ToshioWoo/Submersible-Mechanical-Crab/MCG2101 - Group 13 Deliverable 1.docx

MCG2101 – Intro Design of MCG Systems

Deliverable 1

Group 13

Names:

Haneen Barghouti

Lara Al Nakeeb

Emma Cochran

Linh Nguyen

Toshio Woo

Definition of Mandate

The mandate is to develop a design for the manufacture of a European Green Crab mechanical mimic to aid in underwater exploration and research in the Gulf of St. Lawrence. The design must be suitable for operation in benthic and coastal environments on various irregular and deformable surfaces, typical of the crab’s preferred environment. The design must operate in the Gulf of St. Lawrence, near shore, in shallow waters less than 6 meters in depth, and in temperatures between -5ºC and 20ºC. It should be able to travel through the Gulf’s various environments including salt marshes, sandy beaches, and sheltered areas such as eelgrass beds. The device must be able to mimic the lateral locomotion and orientation of a European Green Crab with maximum stability. The mimic must be able to attach to the seabed, must be able to reposition itself should it become stuck, and must be able to flip itself over if it falls upside down. The device must interact with and monitor marine life while minimizing disturbances to the surrounding ecosystem. It must be capable of collecting data with a sampling mechanism; however, its observation and locomotion procedures must minimize water turbidity, disruption to sediment, damage to vegetation, and interference with other marine organisms. The device must be made of material that is resistant to sun, salt, and sand damage. Furthermore, the material properties must not harm or disrupt other marine life. The design’s structure should maximize the mimic’s resemblance to the green crab and should be between 70mm and 86mm in carapace breadth, and it must also be compatible with conventional manufacturing processes available in Canada.

Criteria and Restrictions

Operational Characteristics:

1. [C] Stability of system for observation must be maximized
2. [C] Stability must not be compromised due to uneven surfaces (ex. rocks, sand).
3. [C] Robot’s ability to orient itself for observation must be maximized.
4. [C] Total mass should be minimized.
5. [C] Operability while fully submerged under water must be maximized.
6. [C] Causes no disruption to surrounding organisms or environment in operation.
7. [R] Material must not be hazardous to the crab species or other organisms.
8. [C] Effect of heat from exposure to sunlight on the system must be minimized.
9. [R] Crab must be less than 86mm
10. [C] Ease of sample collection is maximized.
11. …
12. [R] Must have no sharp edges or exposed mechanical/electrical elements.
13. [C] Reliability of all subsystems during prolonged use in coastal environment must be maximized.
14. [C] Ease of the robot’s retrieval and deployment must be maximized.
15. [C] Need for maintenance/servicing should be minimized.
16. [R] Must tolerate water depths of at least 6 meters.
17. [C] Movement precision when system is controlled must be maximized.
18. [R] Operation not affected in temperature ranges of the Gulf of St. Lawrence from -5°C to 20°C.
19. [C] Maximized operational ability on irregular terrain found in coastal environments such as pebbled, muddy or sandy surfaces.
20. …
21. [C] Ability to navigate strong currents or contact with debris must be maximized
22. [R] Carapace must be less than 86mm in diameter

Tree Structure Criteria & Restriction

1. Stability
2. Surface
3. Orientation
4. Mass
5. Submersion
6. Disruption
7. Biocompatibility
8. Thermal exposure
9. Compactness
10. Sample collection
11. …
12. Safety
13. Reliability
14. Deployment
15. Maintainability
16. Tolerate Water Depths
17. Movability
18. Temperature Adaptability
19. Operational Ability
20. …
21. Navigation

System Data & Structure

0.10 0.10

Spy Crab Design

1.0

Mechanical & Structural Design

0.25 0.25

0.35 Stability 0.0875

0.3 Surface 0.075

0.25 Orientation 0.0625

0.1 Mass 0.025

1 Thermal Exposure 0.15

Compactness

1 Disruption 0.15

Biocompatibility

Safety

…

…

0.3 Sample Collection0.03

0.25 Maintainability 0.025

0.45 Reliability 0.045

Tolerate Water Depths

1 Submersion 0.15

Temperature Adaptability

0.15 Deployment 0.03

Operational

0.35 Ability 0.07

0.2 Movability 0.04

0.3 Navigation 0.06

Tree Structure

System Requirements

0.15 0.15

Environmental Impact

0.15 0.15

Environmental Tolerance

0.15 0.15

Operational Performance

0.20 0.20

Technical Specification

Criteria & Restrictions | Abs. Weighting | Benchmark
1. Stability maximized | 0.0875 | 0 falls/hour
2. Acceptable terrain types | 0.075 | All
3. Reorientation for view angle | 0.0625 | 360 degrees
4. Mass minimized | 0.025 | <3 kg
5. Submersion, waterproof materials | 0.15 | All
6. Disruption of environment | - | None
7. No biohazardous materials | - | None
8. Sun exposure time without damage | 0.06 | >50 hours
9. Compactness, main body size | 0.09 | 60-90 mm
10. Sample collection size | 0.03 | 5 to 15 mm
11. Seafloor disturbance | 0.15 | None
12. Safety (sharp edges, exposed electronics) | - | None
13. Reliability/lifetime | 0.045 | 500 working hours
14. Deployment and retrieval time | 0.03 | <5 min
15. Regular maintenance time | 0.025 | <20 min/10 working hours
16. Tolerate water depths | - | 6m minimum
17. Movement speed | 0.04 | 0 to 0.2 m/s
18. Working temperature range | - | -5 to 20 °C
19. Tolerable environmental conditions | 0.07 | 90% of days
20. Non-polluting | - | None
21. Tolerable external force (current, debris) | 0.06 | 5 km/h

MCG2101 Group 13
