ToshioWoo/Submersible-Mechanical-Crab/FULL ASSEMBLY 637pm28-03-26/FULL ASSEMBLY/Buoyancy Assembly V5/Buoyancy Assembly V5/Buoyancy Assembly.SLDASM

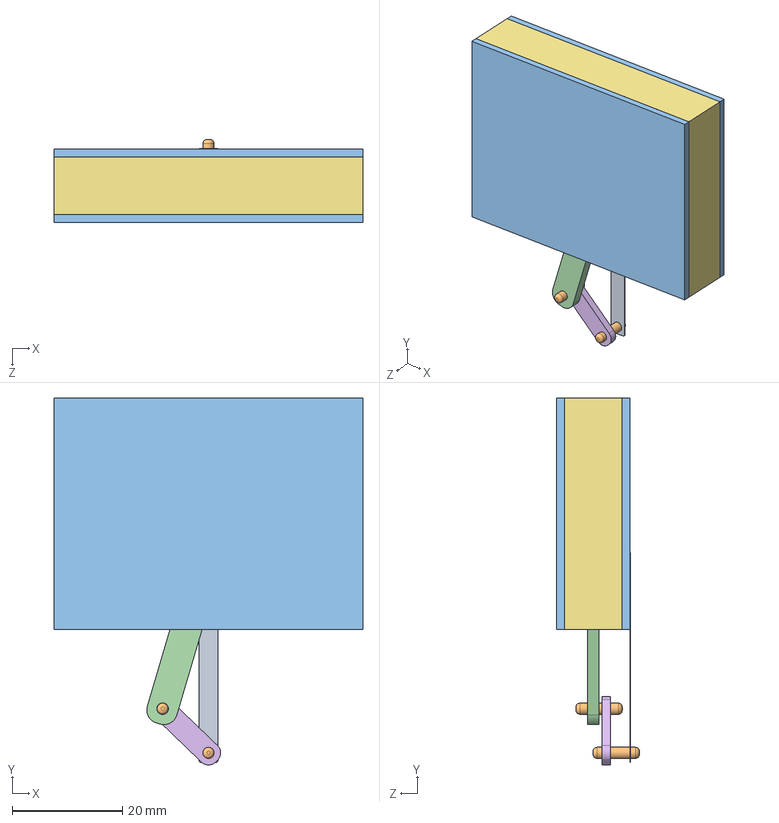
[picture p59: CAD file, 2026-11-10]
FULL ASSEMBLY 637pm28-03-26/FULL ASSEMBLY/Buoyancy Assembly V5/Buoyancy Assembly V5/Buoyancy Assembly.SLDASM
56.0 x 66.6 x 15.0 mm
Casing
Gear Arm 1
Pin
Piston Arm 2
Top and Bottom Casing x 2
Pin 3 x 2
Base Plate
