ToshioWoo/Submersible-Mechanical-Crab/FULL ASSEMBLY 637pm28-03-26/FULL ASSEMBLY/Crab v2/MCG2101_P6_SamplingAssembly_v2.SLDASM

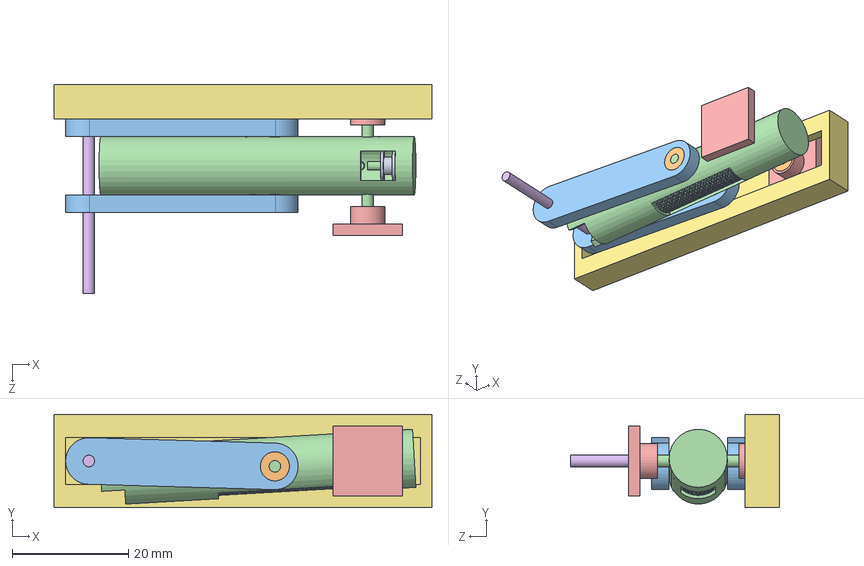
[picture p60: CAD file, 2026-11-10]
FULL ASSEMBLY 637pm28-03-26/FULL ASSEMBLY/Crab v2/MCG2101_P6_SamplingAssembly_v2.SLDASM
65.0 x 16.0 x 36.0 mm
MCG2101_P6_LeftCase
MCG2101_P6_ShaftM
MCG2101_P6_Slider x 2
MCG2101_P5_Cylinder
MCG2101_P6_Linkage x 2
MCG2101_P6_2-5_Bearing x 4
MCG2101_P6_H_Pulley
