ToshioWoo/Submersible-Mechanical-Crab/FULL ASSEMBLY 637pm28-03-26/FULL ASSEMBLY/FULL ASSEMBLY V1 -LARA/Buoyancy/Buoyancy Assembly.SLDASM

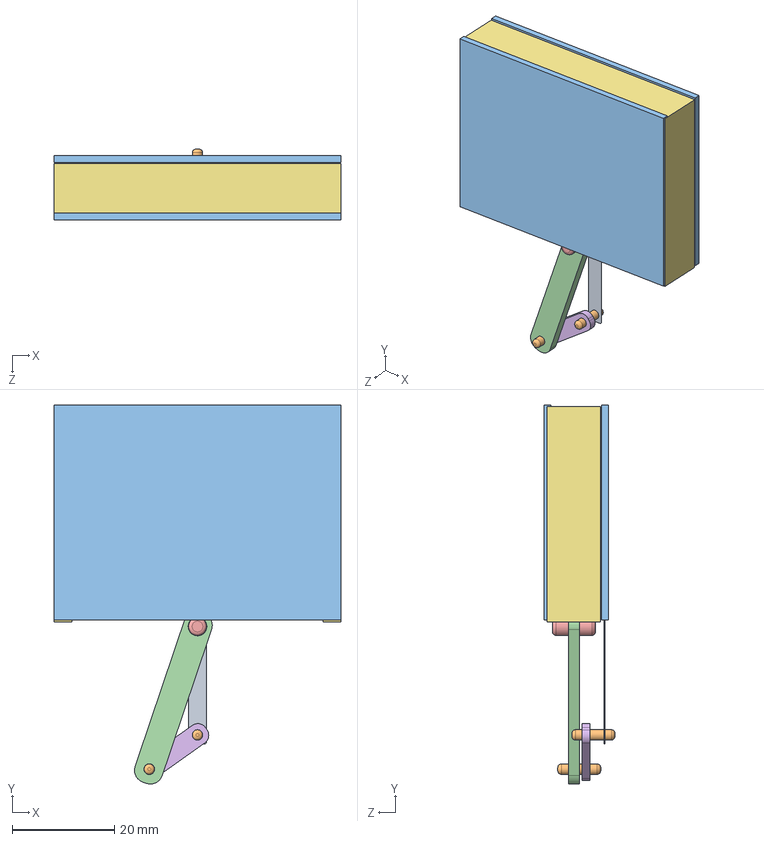
[picture p61: CAD file, 2026-11-10]
FULL ASSEMBLY 637pm28-03-26/FULL ASSEMBLY/FULL ASSEMBLY V1 -LARA/Buoyancy/Buoyancy Assembly.SLDASM
56.0 x 74.0 x 13.8 mm
Casing
Gear Arm 1
Pin
Piston Arm 2
Top and Bottom Casing x 2
Pin 3 x 2
Base Plate
