ToshioWoo/Submersible-Mechanical-Crab/FULL ASSEMBLY 637pm28-03-26/FULL ASSEMBLY/Buoyancy Assembly V5/Buoyancy Assembly V5/Casing.SLDPRT

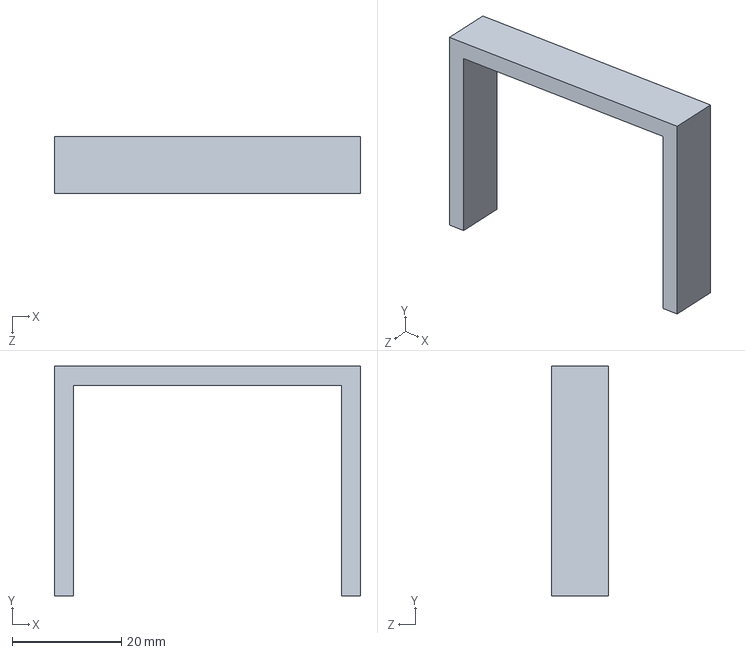
[picture p62: CAD file, 2026-11-10]
FULL ASSEMBLY 637pm28-03-26/FULL ASSEMBLY/Buoyancy Assembly V5/Buoyancy Assembly V5/Casing.SLDPRT
56.0 x 42.0 x 10.5 mm
