ToshioWoo/Submersible-Mechanical-Crab/FULL ASSEMBLY 637pm28-03-26/FULL ASSEMBLY/Crab v2/MCG2101_P6_S_Pulley.SLDPRT

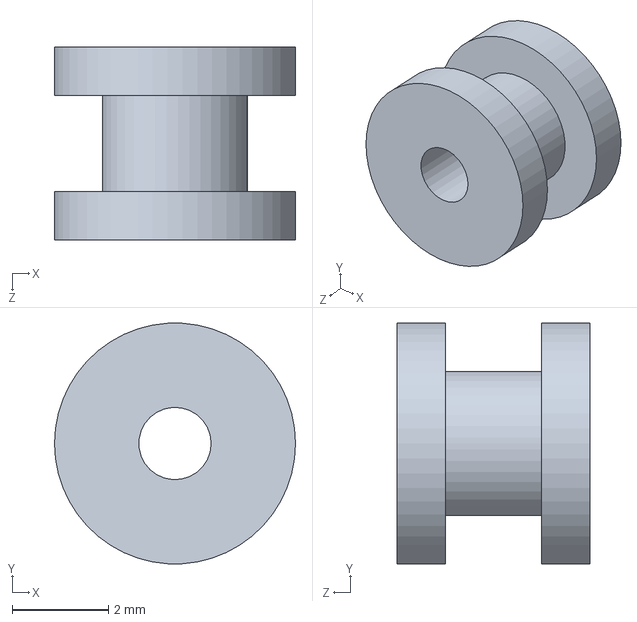
[picture p63: CAD file, 2026-11-10]
FULL ASSEMBLY 637pm28-03-26/FULL ASSEMBLY/Crab v2/MCG2101_P6_S_Pulley.SLDPRT
5.00 x 4.99 x 4.00 mm
