ToshioWoo/Submersible-Mechanical-Crab/FULL ASSEMBLY 637pm28-03-26/FULL ASSEMBLY/Crab v2/Toolbox parts/Metric - Straight bevel gear 0.25M 12GT 12PT 20PA 12FW ---12O75H2MD2N.SLDPRT

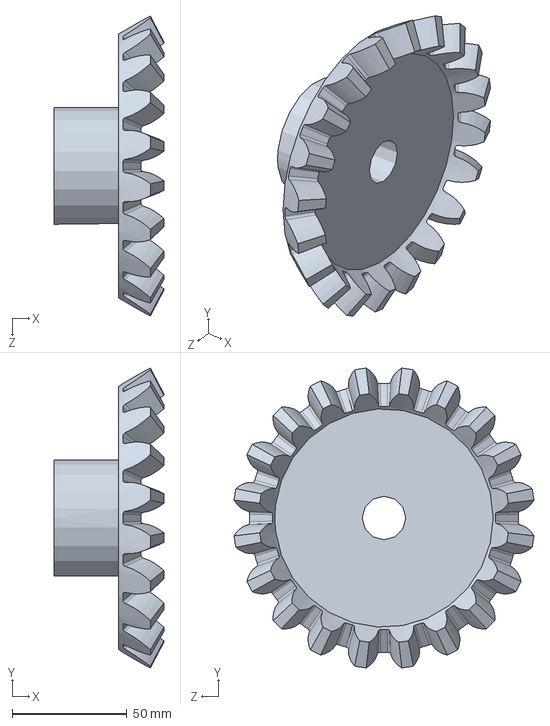
[picture p64: CAD file, 2026-11-10]
FULL ASSEMBLY 637pm28-03-26/FULL ASSEMBLY/Crab v2/Toolbox parts/Metric - Straight bevel gear 0.25M 12GT 12PT 20PA 12FW ---12O75H2MD2N.SLDPRT
47.8 x 130.7 x 130.7 mm
