ToshioWoo/Submersible-Mechanical-Crab/FULL ASSEMBLY 637pm28-03-26/FULL ASSEMBLY/FULL ASSEMBLY V1 -LARA/Buoyancy/New Claw Design - Part 1.SLDPRT

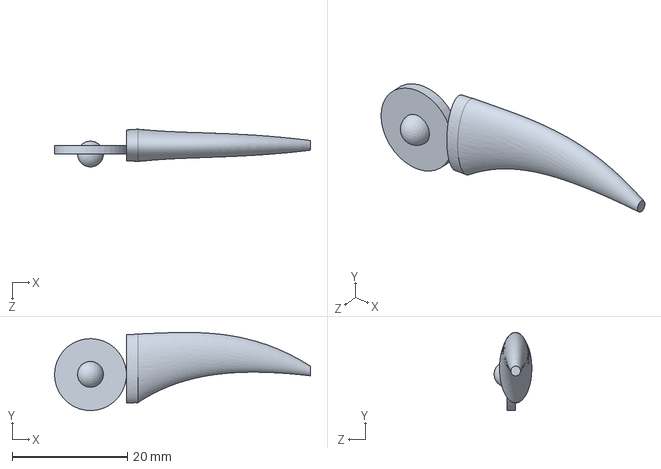
[picture p65: CAD file, 2026-11-10]
FULL ASSEMBLY 637pm28-03-26/FULL ASSEMBLY/FULL ASSEMBLY V1 -LARA/Buoyancy/New Claw Design - Part 1.SLDPRT
44.5 x 13.6 x 6.56 mm
