ToshioWoo/Submersible-Mechanical-Crab/FULL ASSEMBLY 637pm28-03-26/FULL ASSEMBLY/FULL ASSEMBLY V1 -LARA/Shell+Legs/Leg2_In.SLDPRT

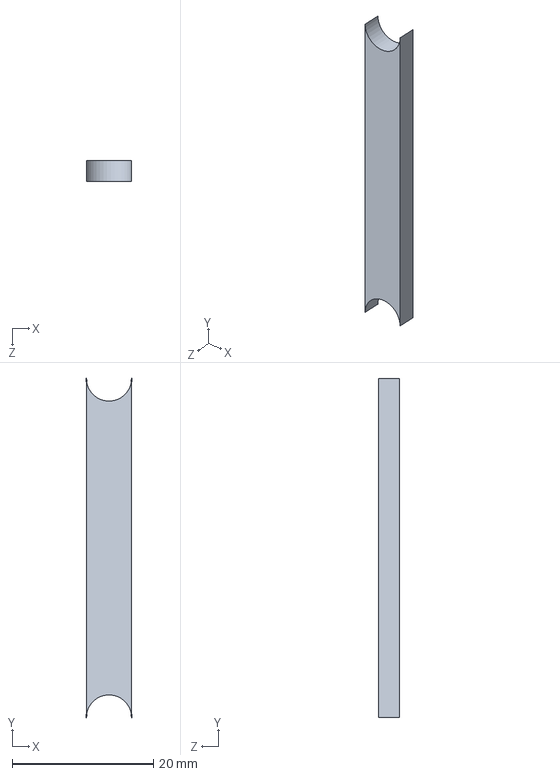
[picture p66: CAD file, 2026-11-10]
FULL ASSEMBLY 637pm28-03-26/FULL ASSEMBLY/FULL ASSEMBLY V1 -LARA/Shell+Legs/Leg2_In.SLDPRT
6.40 x 48.0 x 3.00 mm
