ToshioWoo/Submersible-Mechanical-Crab/FULL ASSEMBLY 637pm28-03-26/FULL ASSEMBLY/MCG 2101/MCG2101_P6_LeftCase._V2SLDPRT.SLDPRT

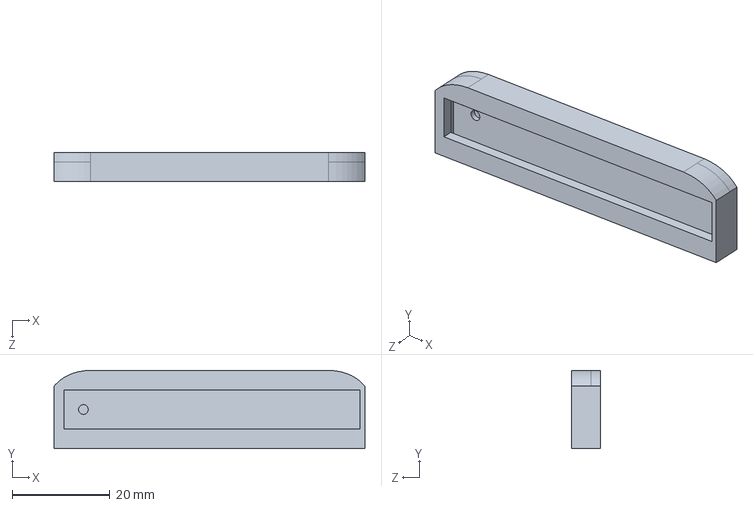
[picture p67: CAD file, 2026-11-10]
FULL ASSEMBLY 637pm28-03-26/FULL ASSEMBLY/MCG 2101/MCG2101_P6_LeftCase._V2SLDPRT.SLDPRT
63.5 x 16.0 x 6.00 mm
