ToshioWoo/Submersible-Mechanical-Crab/FULL ASSEMBLY 637pm28-03-26/FULL ASSEMBLY/MCG 2101/Toolbox parts/AFBMA 12.1.4.1 - 0015-4 - 8,SI,NC,8_68.SLDPRT

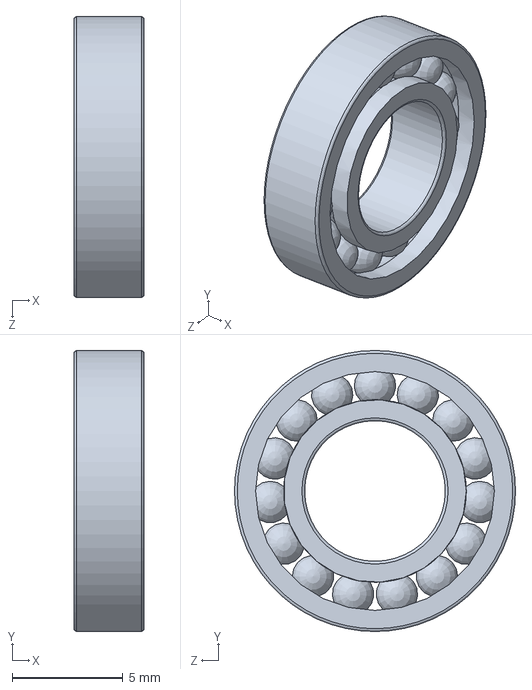
[picture p68: CAD file, 2026-11-10]
FULL ASSEMBLY 637pm28-03-26/FULL ASSEMBLY/MCG 2101/Toolbox parts/AFBMA 12.1.4.1 - 0015-4 - 8,SI,NC,8_68.SLDPRT
3.17 x 12.7 x 12.7 mm
