ToshioWoo/Submersible-Mechanical-Crab/FULL ASSEMBLY 637pm28-03-26/FULL ASSEMBLY/Buoyancy Assembly V5/Buoyancy Assembly V5/Base Plate.SLDPRT

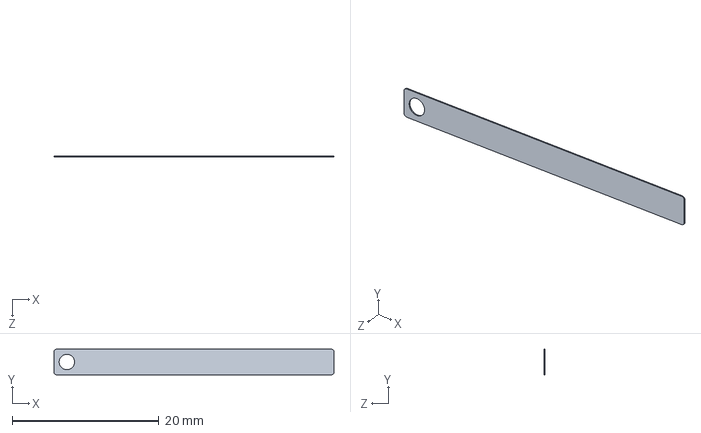
[picture p69: CAD file, 2026-11-10]
FULL ASSEMBLY 637pm28-03-26/FULL ASSEMBLY/Buoyancy Assembly V5/Buoyancy Assembly V5/Base Plate.SLDPRT
38.1 x 3.50 x 0.14 mm
