ToshioWoo/Submersible-Mechanical-Crab/FULL ASSEMBLY 637pm28-03-26/FULL ASSEMBLY/MCG 2101/MCG2101_P6_Linkage.SLDPRT

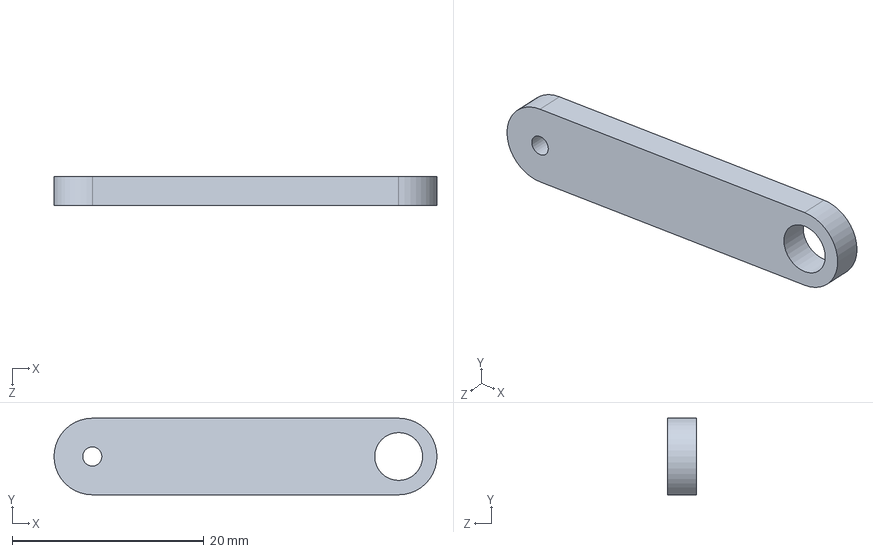
[picture p70: CAD file, 2026-11-10]
FULL ASSEMBLY 637pm28-03-26/FULL ASSEMBLY/MCG 2101/MCG2101_P6_Linkage.SLDPRT
40.0 x 8.00 x 3.00 mm
