ToshioWoo/Submersible-Mechanical-Crab/FULL ASSEMBLY 637pm28-03-26/FULL ASSEMBLY/Crab v2/MCG2101_P6_LeftCase.SLDPRT

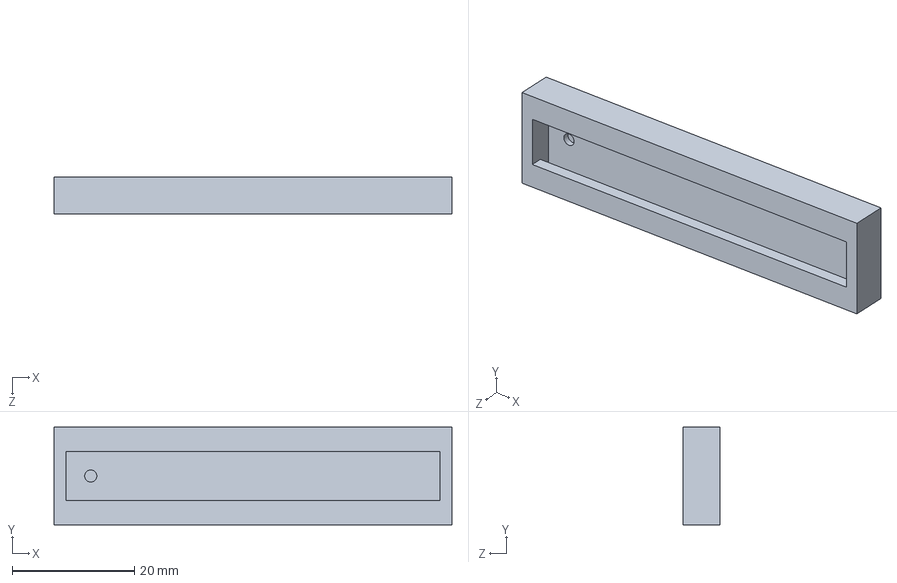
[picture p71: CAD file, 2026-11-10]
FULL ASSEMBLY 637pm28-03-26/FULL ASSEMBLY/Crab v2/MCG2101_P6_LeftCase.SLDPRT
65.0 x 16.0 x 6.00 mm
