ToshioWoo/Submersible-Mechanical-Crab/FULL ASSEMBLY 637pm28-03-26/FULL ASSEMBLY/FULL ASSEMBLY V1 -LARA/Buoyancy/Pin.SLDPRT

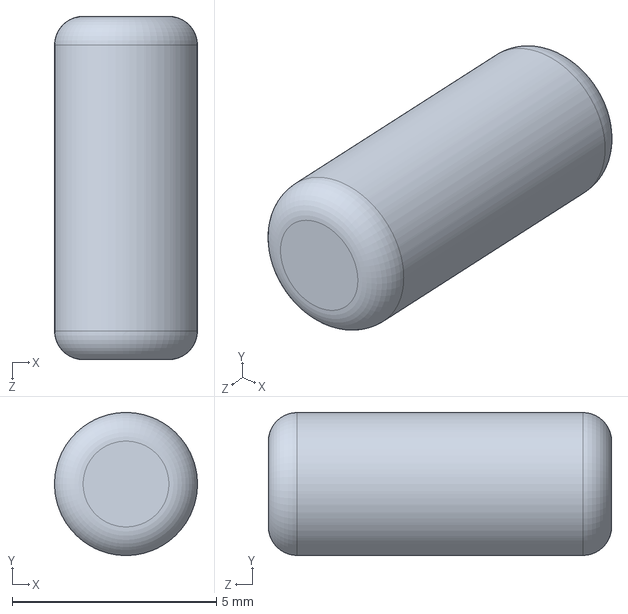
[picture p72: CAD file, 2026-11-10]
FULL ASSEMBLY 637pm28-03-26/FULL ASSEMBLY/FULL ASSEMBLY V1 -LARA/Buoyancy/Pin.SLDPRT
3.50 x 3.50 x 8.40 mm
