ToshioWoo/Submersible-Mechanical-Crab/FULL ASSEMBLY 637pm28-03-26/FULL ASSEMBLY/FULL ASSEMBLY V1 -LARA/Shell+Legs/Leg3_In.SLDPRT

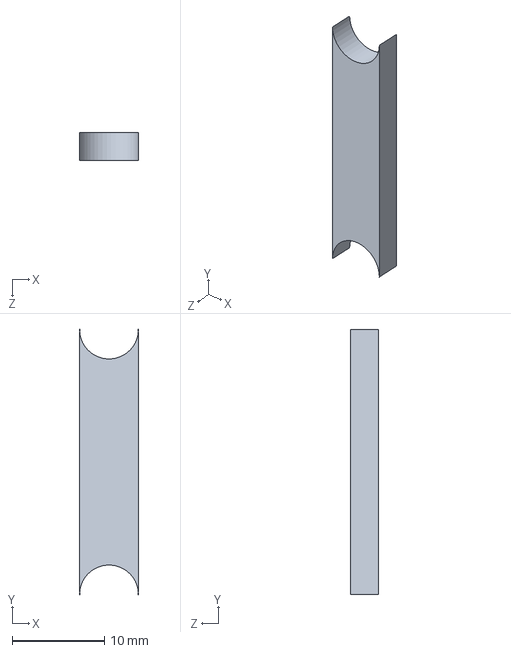
[picture p73: CAD file, 2026-11-10]
FULL ASSEMBLY 637pm28-03-26/FULL ASSEMBLY/FULL ASSEMBLY V1 -LARA/Shell+Legs/Leg3_In.SLDPRT
6.40 x 28.8 x 3.00 mm
