ToshioWoo/Submersible-Mechanical-Crab/FULL ASSEMBLY 637pm28-03-26/FULL ASSEMBLY/MCG 2101/MCG2101_P6_Slider.SLDPRT

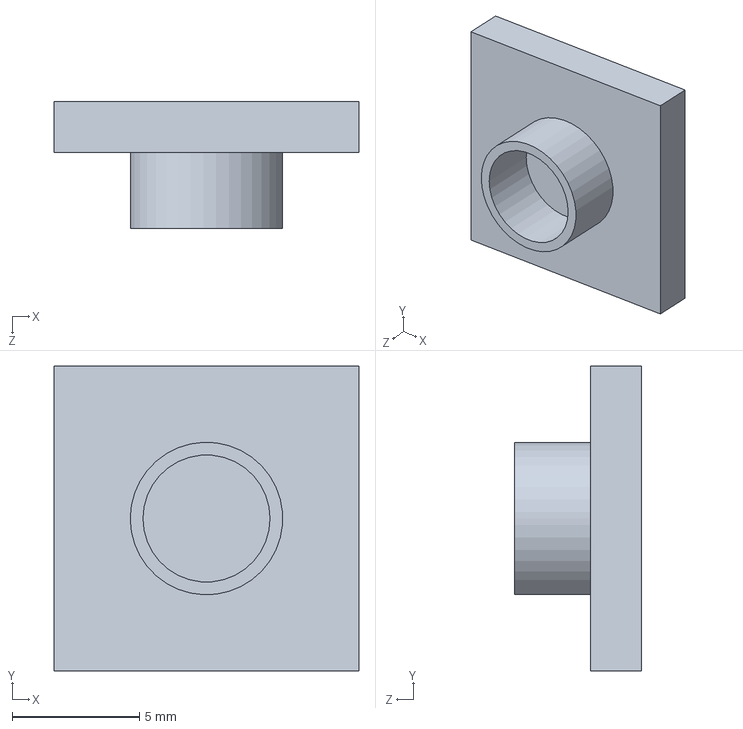
[picture p74: CAD file, 2026-11-10]
FULL ASSEMBLY 637pm28-03-26/FULL ASSEMBLY/MCG 2101/MCG2101_P6_Slider.SLDPRT
12.0 x 12.0 x 5.00 mm
