ToshioWoo/Submersible-Mechanical-Crab/FULL ASSEMBLY 637pm28-03-26/FULL ASSEMBLY/Buoyancy Assembly V5/Buoyancy Assembly V5/Top and Bottom Casing.SLDPRT

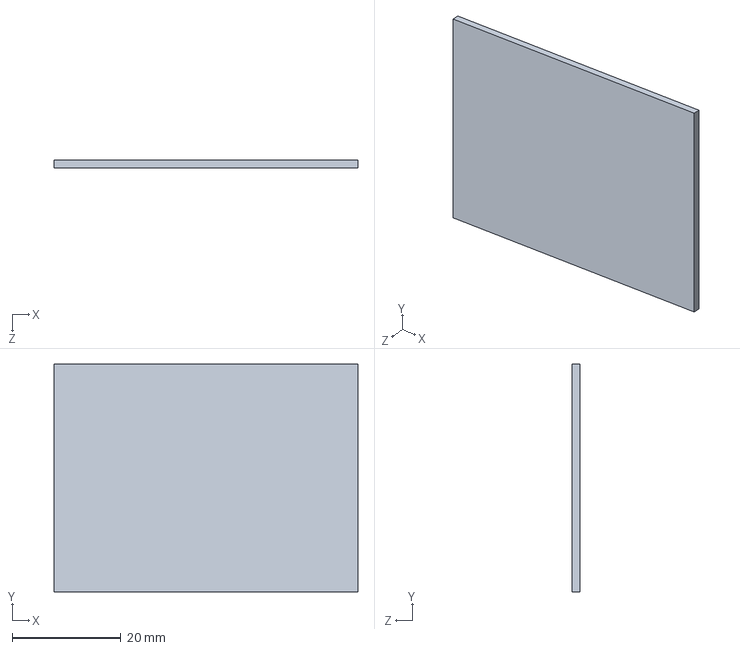
[picture p75: CAD file, 2026-11-10]
FULL ASSEMBLY 637pm28-03-26/FULL ASSEMBLY/Buoyancy Assembly V5/Buoyancy Assembly V5/Top and Bottom Casing.SLDPRT
56.0 x 42.0 x 1.40 mm
