ToshioWoo/Submersible-Mechanical-Crab/FULL ASSEMBLY 637pm28-03-26/FULL ASSEMBLY/Crab v2/MCG2101_P6_2-5_Bearing.SLDPRT

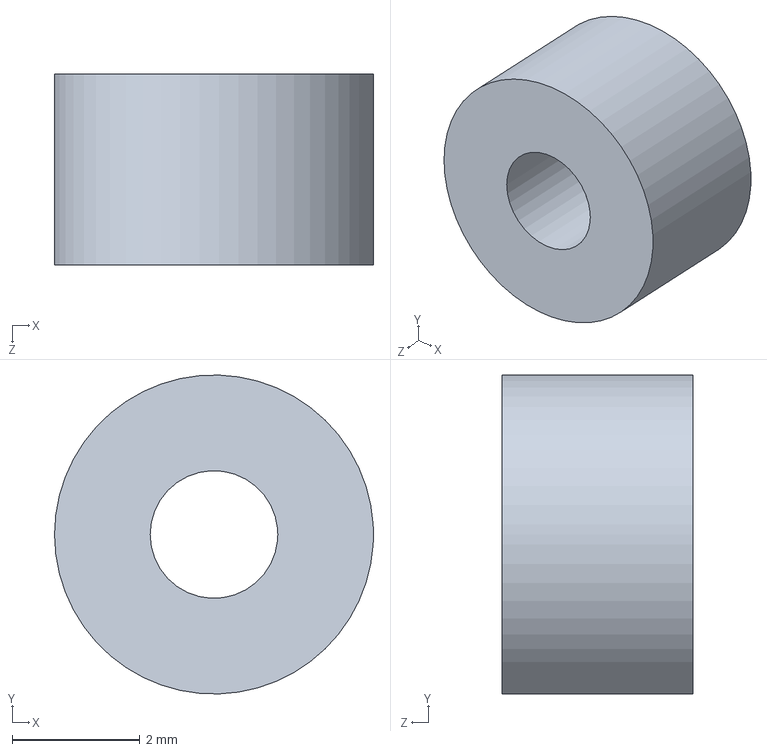
[picture p76: CAD file, 2026-11-10]
FULL ASSEMBLY 637pm28-03-26/FULL ASSEMBLY/Crab v2/MCG2101_P6_2-5_Bearing.SLDPRT
5.00 x 5.00 x 3.00 mm
