ToshioWoo/Submersible-Mechanical-Crab/FULL ASSEMBLY 637pm28-03-26/FULL ASSEMBLY/FULL ASSEMBLY V1 -LARA/Buoyancy/Gear Arm 1.SLDPRT

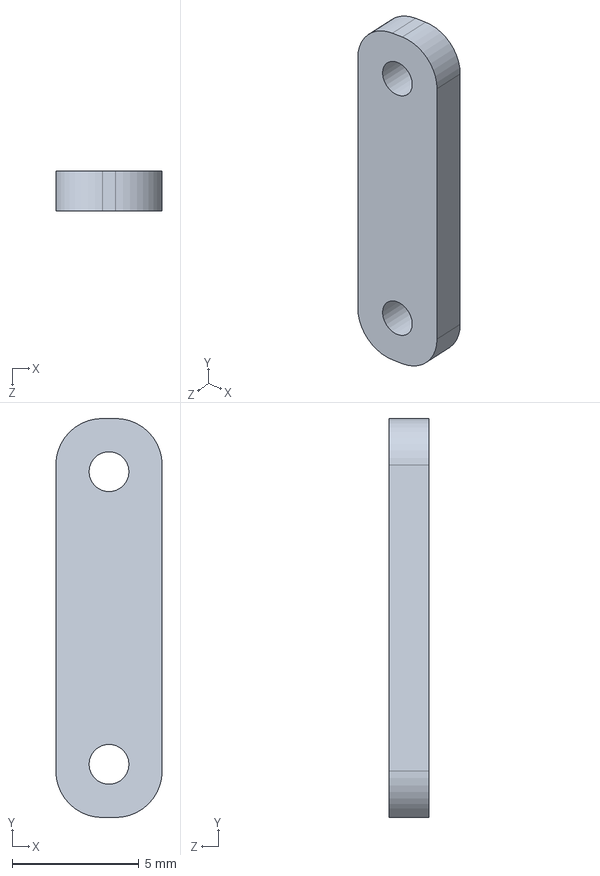
[picture p77: CAD file, 2026-11-10]
FULL ASSEMBLY 637pm28-03-26/FULL ASSEMBLY/FULL ASSEMBLY V1 -LARA/Buoyancy/Gear Arm 1.SLDPRT
4.20 x 15.8 x 1.58 mm
