ToshioWoo/Submersible-Mechanical-Crab/FULL ASSEMBLY 637pm28-03-26/FULL ASSEMBLY/MCG 2101/MCG2101_P5_Cylinder.SLDPRT

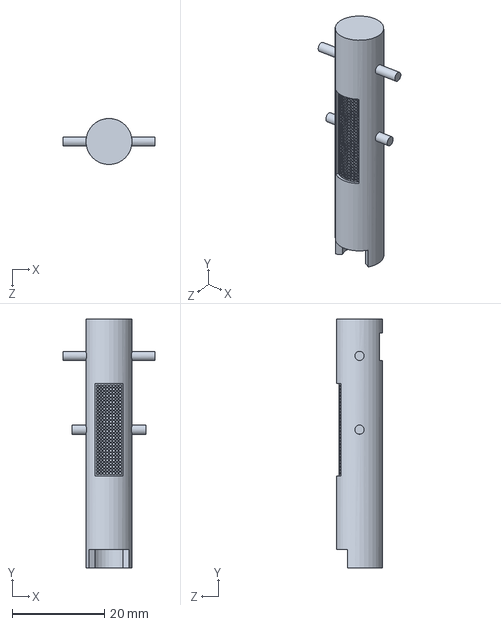
[picture p78: CAD file, 2026-11-10]
FULL ASSEMBLY 637pm28-03-26/FULL ASSEMBLY/MCG 2101/MCG2101_P5_Cylinder.SLDPRT
20.0 x 54.0 x 10.0 mm
