ToshioWoo/Submersible-Mechanical-Crab/FULL ASSEMBLY 637pm28-03-26/FULL ASSEMBLY/FULL ASSEMBLY V1 -LARA/Buoyancy/Pin 3.SLDPRT

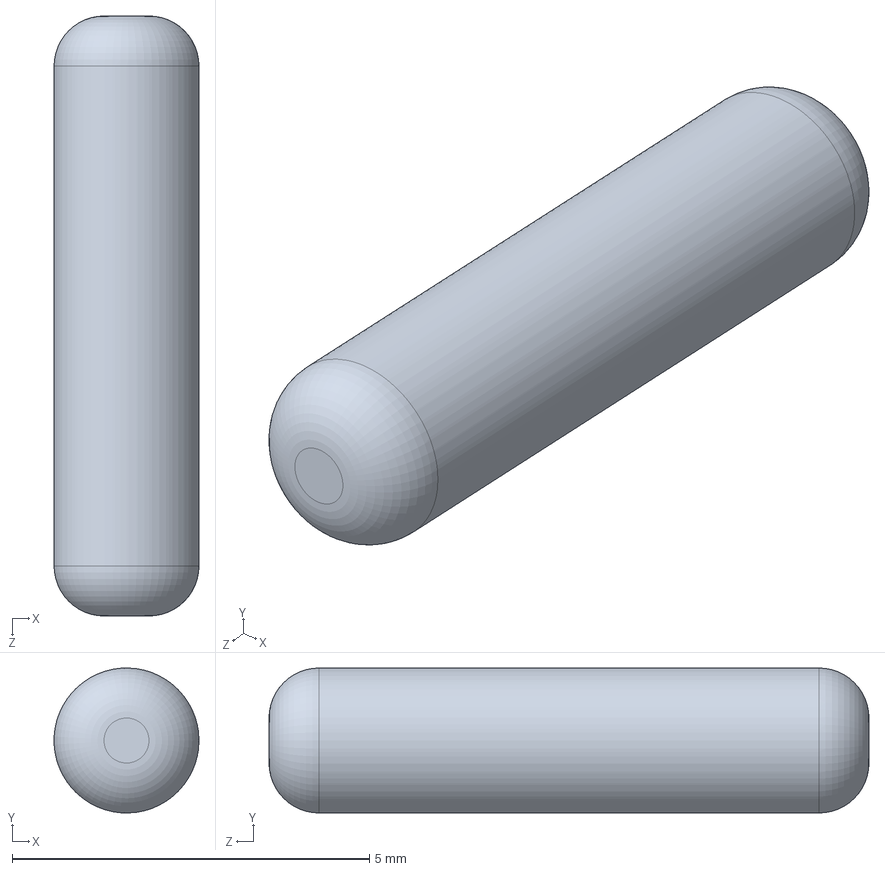
[picture p79: CAD file, 2026-11-10]
FULL ASSEMBLY 637pm28-03-26/FULL ASSEMBLY/FULL ASSEMBLY V1 -LARA/Buoyancy/Pin 3.SLDPRT
2.03 x 2.03 x 8.40 mm
