ToshioWoo/Submersible-Mechanical-Crab/FULL ASSEMBLY 637pm28-03-26/FULL ASSEMBLY/FULL ASSEMBLY V1 -LARA/Shell+Legs/Friction Pad 2.0 (1).SLDPRT

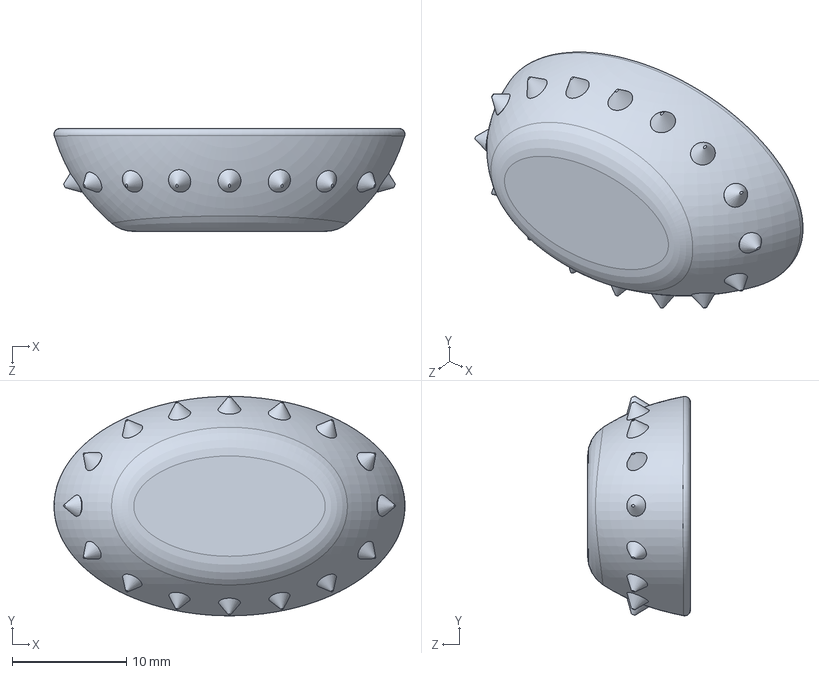
[picture p80: CAD file, 2026-11-10]
FULL ASSEMBLY 637pm28-03-26/FULL ASSEMBLY/FULL ASSEMBLY V1 -LARA/Shell+Legs/Friction Pad 2.0 (1).SLDPRT
30.7 x 19.2 x 9.00 mm
