ToshioWoo/Submersible-Mechanical-Crab/FULL ASSEMBLY 637pm28-03-26/FULL ASSEMBLY/MCG 2101/MCG2101_P6_ShaftM.SLDPRT

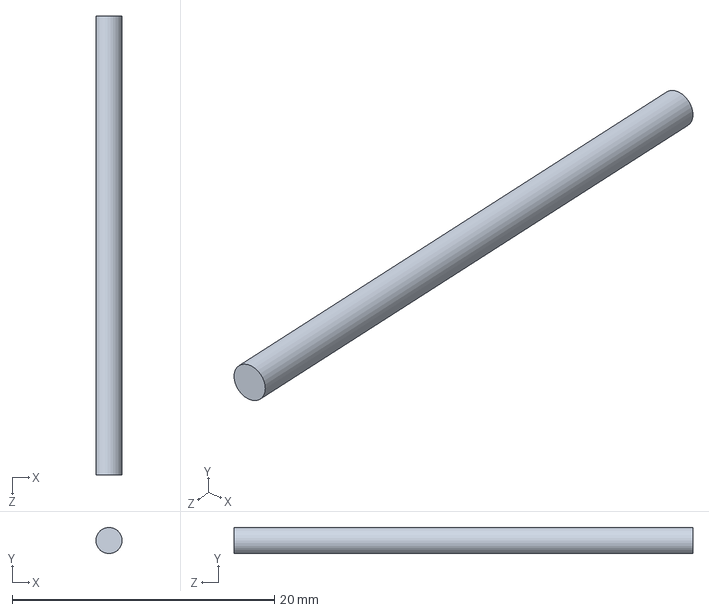
[picture p81: CAD file, 2026-11-10]
FULL ASSEMBLY 637pm28-03-26/FULL ASSEMBLY/MCG 2101/MCG2101_P6_ShaftM.SLDPRT
2.00 x 1.99 x 35.0 mm
