ToshioWoo/Submersible-Mechanical-Crab/FULL ASSEMBLY 637pm28-03-26/FULL ASSEMBLY/Buoyancy Assembly V5/Buoyancy Assembly V5/Piston Arm 2.SLDPRT

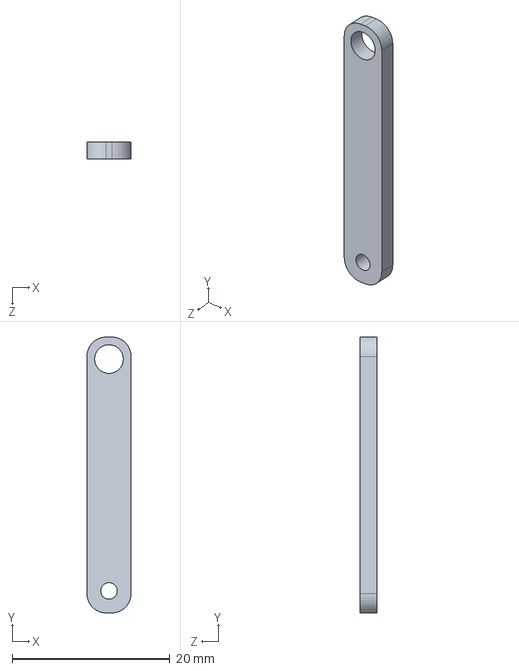
[picture p82: CAD file, 2026-11-10]
FULL ASSEMBLY 637pm28-03-26/FULL ASSEMBLY/Buoyancy Assembly V5/Buoyancy Assembly V5/Piston Arm 2.SLDPRT
5.60 x 35.0 x 2.10 mm
