ToshioWoo/Submersible-Mechanical-Crab/FULL ASSEMBLY 637pm28-03-26/FULL ASSEMBLY/FULL ASSEMBLY V1 -LARA/Shell+Legs/Leg5_Out.SLDPRT

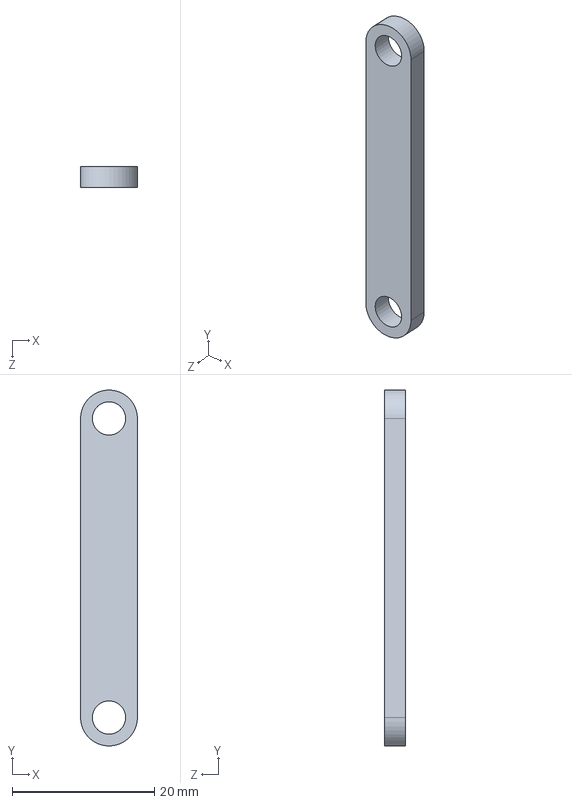
[picture p83: CAD file, 2026-11-10]
FULL ASSEMBLY 637pm28-03-26/FULL ASSEMBLY/FULL ASSEMBLY V1 -LARA/Shell+Legs/Leg5_Out.SLDPRT
8.00 x 50.0 x 3.00 mm
