ToshioWoo/Submersible-Mechanical-Crab/FULL ASSEMBLY 637pm28-03-26/FULL ASSEMBLY/MCG 2101/MCG2101_P6_H_Pulley.SLDPRT

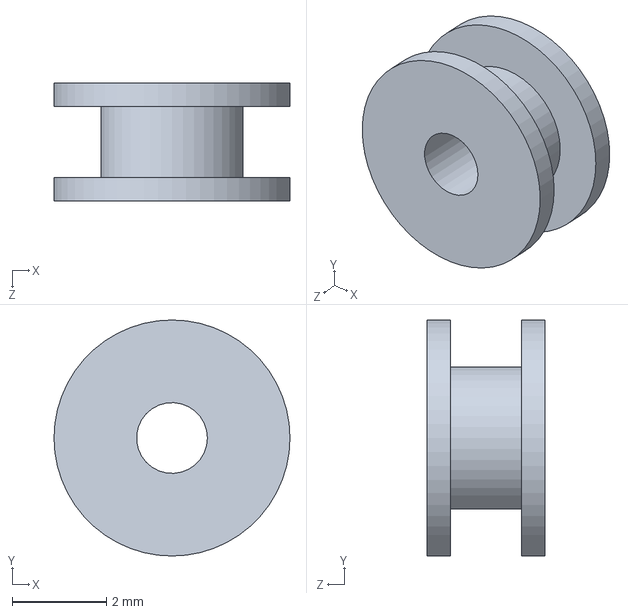
[picture p84: CAD file, 2026-11-10]
FULL ASSEMBLY 637pm28-03-26/FULL ASSEMBLY/MCG 2101/MCG2101_P6_H_Pulley.SLDPRT
5.00 x 5.00 x 2.50 mm
