ToshioWoo/Submersible-Mechanical-Crab/FULL ASSEMBLY 637pm28-03-26/FULL ASSEMBLY/FULL ASSEMBLY V1 -LARA/Shell+Legs/Attachment.SLDPRT

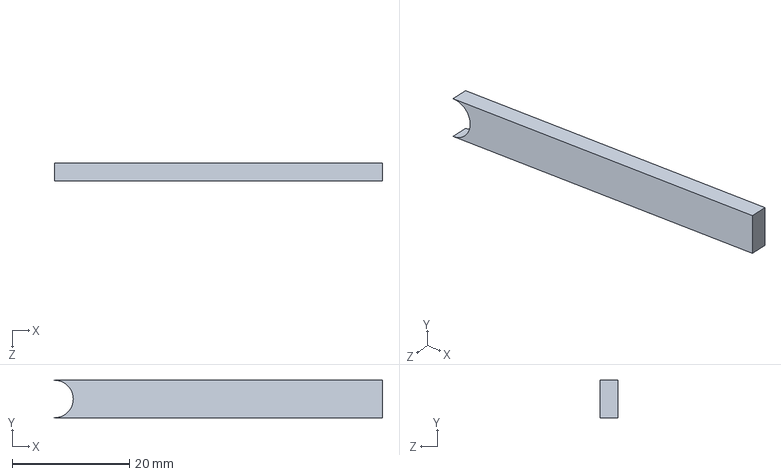
[picture p87: CAD file, 2026-11-10]
FULL ASSEMBLY 637pm28-03-26/FULL ASSEMBLY/FULL ASSEMBLY V1 -LARA/Shell+Legs/Attachment.SLDPRT
55.8 x 6.40 x 3.00 mm
