ToshioWoo/Submersible-Mechanical-Crab/FULL ASSEMBLY 637pm28-03-26/FULL ASSEMBLY/Crab v2/TensionerSpring.SLDPRT

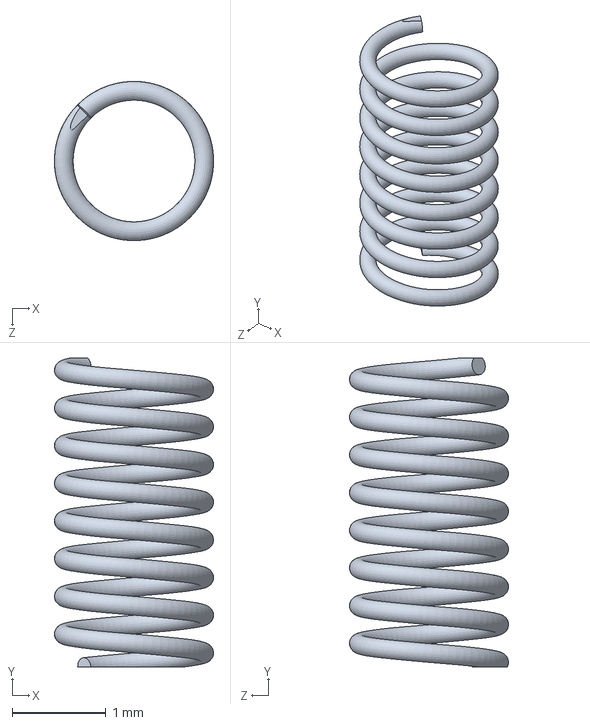
[picture p88: CAD file, 2026-11-10]
FULL ASSEMBLY 637pm28-03-26/FULL ASSEMBLY/Crab v2/TensionerSpring.SLDPRT
1.70 x 3.30 x 1.70 mm
