ToshioWoo/Submersible-Mechanical-Crab/FULL ASSEMBLY 637pm28-03-26/FULL ASSEMBLY/Crab v2/TensionSlider.SLDPRT

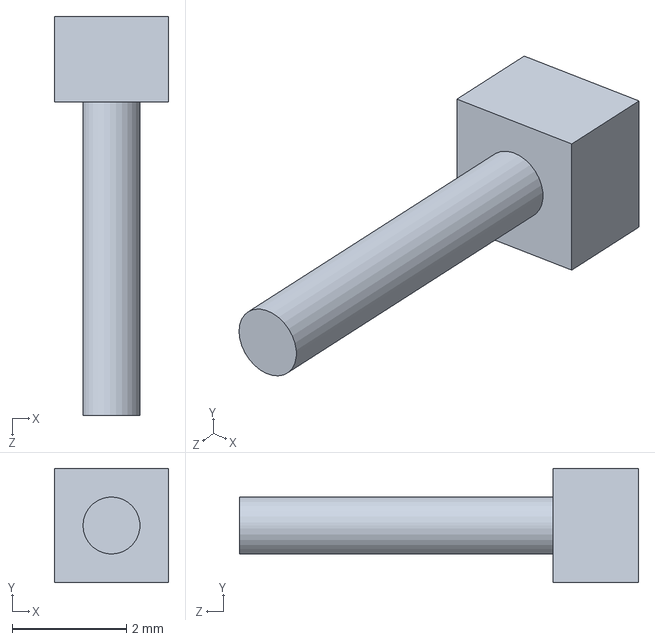
[picture p92: CAD file, 2026-11-10]
FULL ASSEMBLY 637pm28-03-26/FULL ASSEMBLY/Crab v2/TensionSlider.SLDPRT
2.00 x 2.00 x 7.00 mm
