ToshioWoo/Submersible-Mechanical-Crab/FULL ASSEMBLY 637pm28-03-26/FULL ASSEMBLY/Crab v2/TensionerPulley.SLDPRT

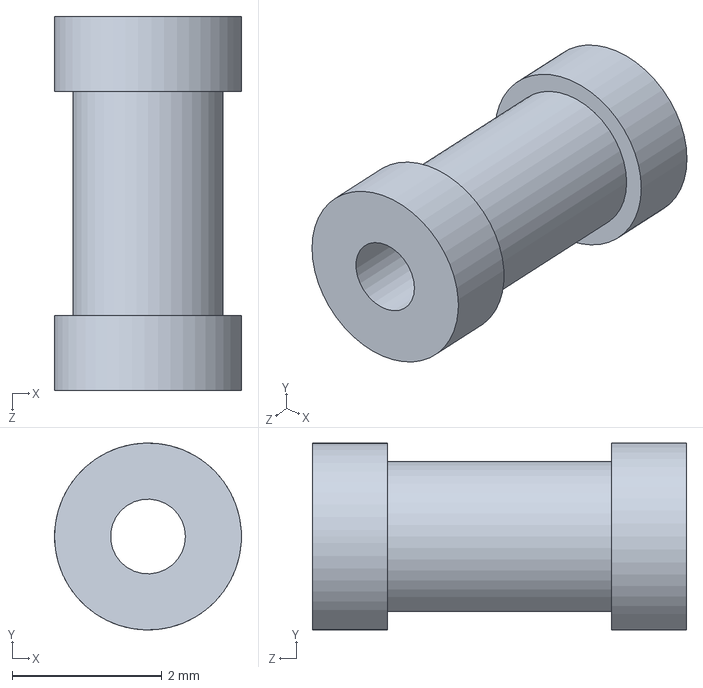
[picture p102: CAD file, 2026-11-10]
FULL ASSEMBLY 637pm28-03-26/FULL ASSEMBLY/Crab v2/TensionerPulley.SLDPRT
2.50 x 2.50 x 5.00 mm
