ToshioWoo/Submersible-Mechanical-Crab/FULL ASSEMBLY 637pm28-03-26/FULL ASSEMBLY/FULL ASSEMBLY V1 -LARA/Shell+Legs/Klann_Linkage1.SLDASM

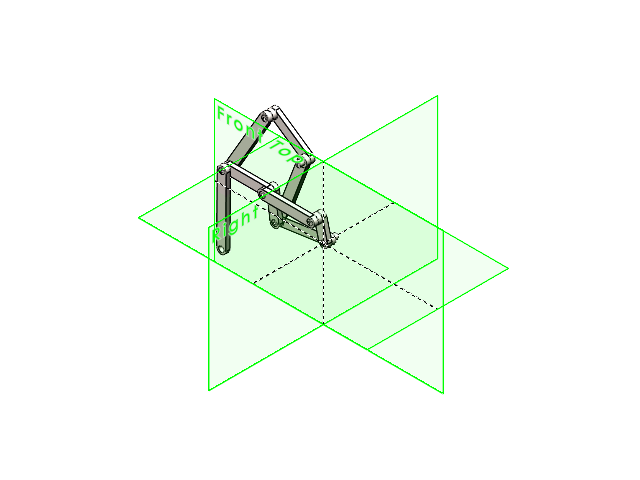
[picture p122: CAD file, 2026-11-10]
FULL ASSEMBLY 637pm28-03-26/FULL ASSEMBLY/FULL ASSEMBLY V1 -LARA/Shell+Legs/Klann_Linkage1.SLDASM
Leg4_Out
Frame_Bottom
Frame_Side
Leg7_Out
Leg3_In
Leg1_Out
Leg2_Out
Leg3_Out
Leg6_Out
Inner shell x 7
