ToshioWoo/Submersible-Mechanical-Crab/FULL ASSEMBLY 637pm28-03-26/FULL ASSEMBLY/MCG 2101/MCG2101_P6_SamplingAssembly.SLDASM

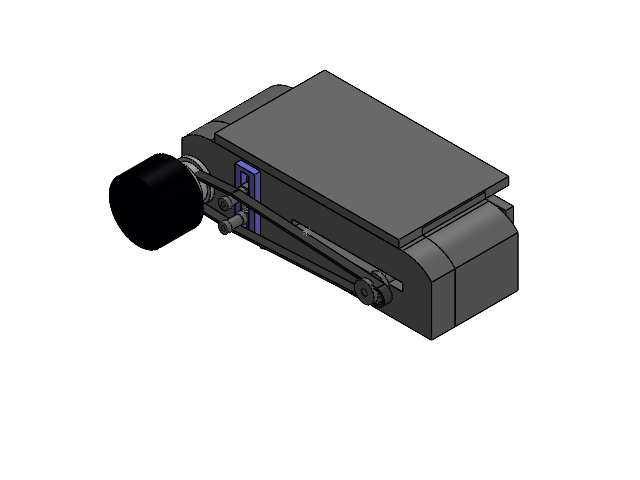
[picture p123: CAD file, 2026-11-10]
FULL ASSEMBLY 637pm28-03-26/FULL ASSEMBLY/MCG 2101/MCG2101_P6_SamplingAssembly.SLDASM
MCG2101_P6_ShaftM
MCG2101_P6_Slider_V2 x 2
MCG2101_P6_Cylinder
MCG2101_P6_Linkage x 2
MCG2101_P6_2-5_Bearing x 2
MCG2101_P5_Screw
MCG2101_P6_RightCase_v2
MCG2101_P6_M_Pulley
MCG2101_P6_Shaft_S
instrument ball bearing_68_am x 4
MCG2101_P6_S_Pulley
Part2^MCG2101_P6_SamplingAssembly
Part5^MCG2101_P6_SamplingAssembly
TensionSlider x 2
TensionerPulley x 2
Part9^MCG2101_P6_SamplingAssembly
TensionerSpring
Part12^MCG2101_P6_SamplingAssembly
Part14^MCG2101_P6_SamplingAssembly x 2
Belt3-10^MCG2101_P6_SamplingAssembly
