ToshioWoo/Submersible-Mechanical-Crab/FULL ASSEMBLY 637pm28-03-26/FULL ASSEMBLY/FULL ASSEMBLY V1 -LARA/Buoyancy/Shell Assembly V4.SLDASM

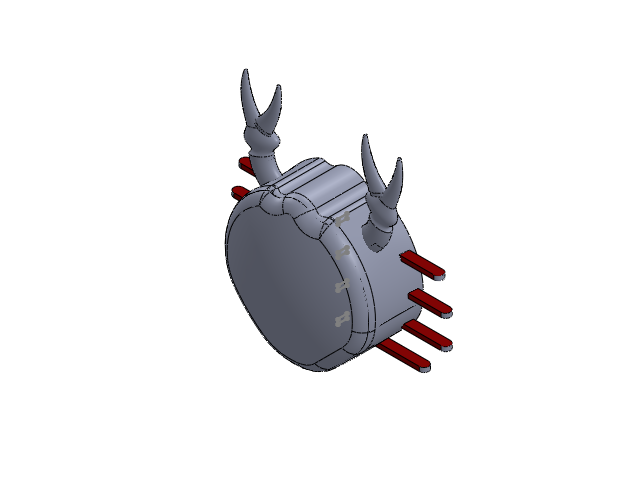
[picture p124: CAD file, 2026-11-10]
FULL ASSEMBLY 637pm28-03-26/FULL ASSEMBLY/FULL ASSEMBLY V1 -LARA/Buoyancy/Shell Assembly V4.SLDASM
Crab Shell Outer
New Claw Design x 2
New Claw Design - Part 1 x 2
Crab Shell Inner
