ToshioWoo/Submersible-Mechanical-Crab/FULL ASSEMBLY 637pm28-03-26/FULL ASSEMBLY/MCG 2101/MCG2101_P6_SamplingAssembly_v2.SLDASM

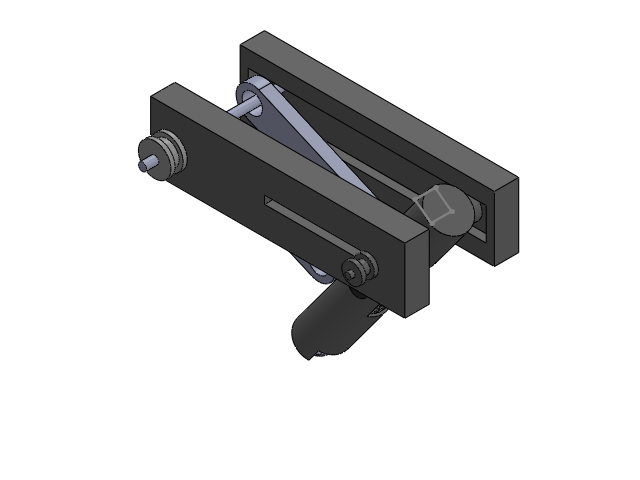
[picture p126: CAD file, 2026-11-10]
FULL ASSEMBLY 637pm28-03-26/FULL ASSEMBLY/MCG 2101/MCG2101_P6_SamplingAssembly_v2.SLDASM
MCG2101_P6_LeftCase._V2SLDPRT
MCG2101_P6_ShaftM
MCG2101_P6_Slider_V2 x 2
MCG2101_P6_Cylinder
MCG2101_P6_Linkage x 2
MCG2101_P6_2-5_Bearing x 2
MCG2101_P5_Screw
MCG2101_P6_RightCase_v2
straight bevel gear_am x 2
MCG2101_P6_M_Pulley
MCG2101_P6_Shaft_S
instrument ball bearing_68_am x 4
MCG2101_P6_S_Pulley
