ToshioWoo/Submersible-Mechanical-Crab/FULL ASSEMBLY 637pm28-03-26/FULL ASSEMBLY/FULL ASSEMBLY V1 -LARA/Shell+Legs/Friction Pad Assembly (1).SLDASM

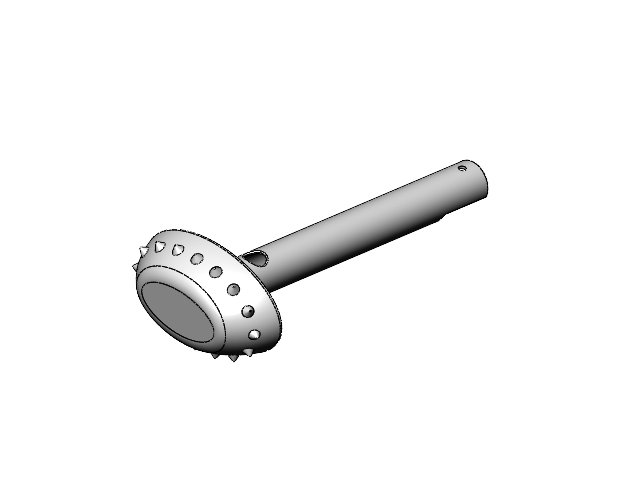
[picture p127: CAD file, 2026-11-10]
FULL ASSEMBLY 637pm28-03-26/FULL ASSEMBLY/FULL ASSEMBLY V1 -LARA/Shell+Legs/Friction Pad Assembly (1).SLDASM
Friction Pad 2.0 (1)
Friction pad ball joint (1)
