ToshioWoo/Submersible-Mechanical-Crab/FULL ASSEMBLY 637pm28-03-26/FULL ASSEMBLY/FULL ASSEMBLY V1 -LARA/Shell+Legs/Crab Shell Assembly.SLDASM

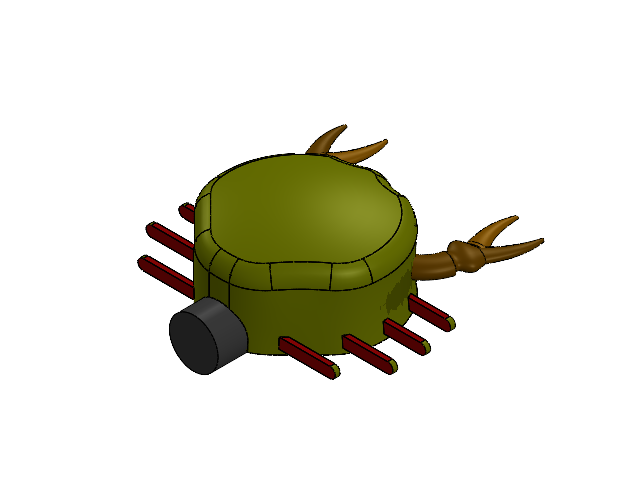
[picture p128: CAD file, 2026-11-10]
FULL ASSEMBLY 637pm28-03-26/FULL ASSEMBLY/FULL ASSEMBLY V1 -LARA/Shell+Legs/Crab Shell Assembly.SLDASM
Crab Shell Outer
Crab Shell Inner
New Claw Design x 2
New Claw Design - Part 1 x 2
Part11^Crab Shell Assembly
Leg Motor
Motor Case^Crab Shell Assembly
