ToshioWoo/Submersible-Mechanical-Crab/FULL ASSEMBLY 637pm28-03-26/FULL ASSEMBLY/FULL ASSEMBLY V1 -LARA/Shell+Legs/Full Assembly v1.0.SLDASM

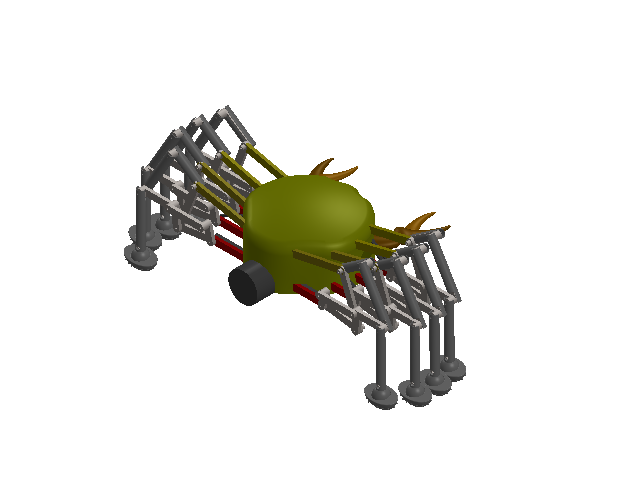
[picture p130: CAD file, 2026-11-10]
FULL ASSEMBLY 637pm28-03-26/FULL ASSEMBLY/FULL ASSEMBLY V1 -LARA/Shell+Legs/Full Assembly v1.0.SLDASM
Crab Shell Outer
Crab Shell Inner
New Claw Design x 2
New Claw Design - Part 1 x 2
Part11^Crab Shell Assembly
Leg Motor
Motor Case^Crab Shell Assembly
Leg4_Out x 8
Frame_Bottom x 8
Frame_Side x 8
Leg7_Out x 8
Leg3_In x 8
Leg1_Out x 8
Leg2_Out x 8
Leg3_Out x 8
Leg6_Out x 8
Inner shell x 56
Part3^Full Assembly v1.0 x 2
Part5^Full Assembly v1.0 x 2
Part6^Full Assembly v1.0 x 2
In Shaft
Belt1
In Shaft Wheel x 2
Connecting pin x 16
Out Shaft Inner x 2
Out Shaft Outer x 2
Ball x 16
Internal Gear x 10
Out Shaft x 4
Bearing and Shaft Attachment Front
Shaft and Bearing Back
Bearing and Shaft Attachment Front Right
Shaft and Bearing Back Right
Trapezoid Belt
Belt 3 x 2
Belt 4 x 2
crab leg shell-top x 8
crab leg shell-middle x 8
Friction Pad 2.0 (1) x 8
Friction pad ball joint (1) x 8
Casing
Gear Arm 1
Pin
Piston
Piston Arm 2
Top and Bottom Casing x 2
Part1^Buoyancy Assembly
Pin 3 x 2
Base Plate
MCG2101_P6_ShaftM
MCG2101_P6_Slider_V2 x 2
MCG2101_P6_Cylinder
MCG2101_P6_Linkage x 2
MCG2101_P6_2-5_Bearing x 2
MCG2101_P5_Screw
MCG2101_P6_RightCase_v2
MCG2101_P6_M_Pulley
MCG2101_P6_Shaft_S
instrument ball bearing_68_am x 4
MCG2101_P6_S_Pulley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
