ToshioWoo/Submersible-Mechanical-Crab/FULL ASSEMBLY 637pm28-03-26/FULL ASSEMBLY/FULL ASSEMBLY V1 -LARA/Shell+Legs/Direction Reversal.SLDASM

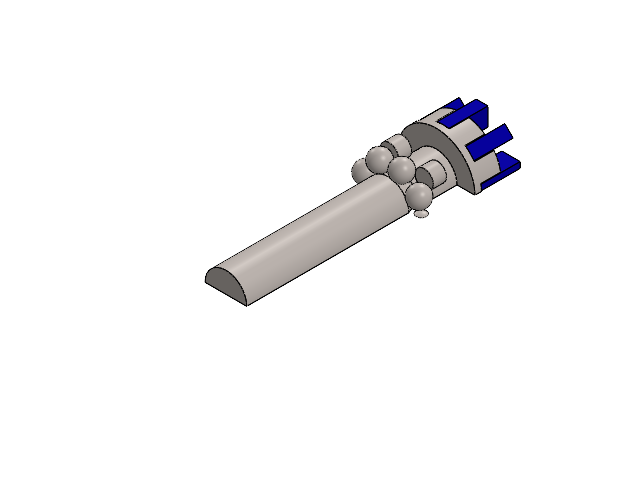
[picture p132: CAD file, 2026-11-10]
FULL ASSEMBLY 637pm28-03-26/FULL ASSEMBLY/FULL ASSEMBLY V1 -LARA/Shell+Legs/Direction Reversal.SLDASM
In Shaft Wheel
Connecting pin x 8
Out Shaft Inner
Out Shaft Outer
Ball x 8
Internal Gear x 5
Out Shaft
