ToshioWoo/Submersible-Mechanical-Crab/(list of files, cad)

Other CAD files:
FULL ASSEMBLY 637pm28-03-26/FULL ASSEMBLY/FULL ASSEMBLY V1 -LARA/Buoyancy/Inner Shell Assembly V1.SLDASM
FULL ASSEMBLY 637pm28-03-26/FULL ASSEMBLY/Crab v2/Toolbox parts/Metric - Straight bevel gear 0.25M 18GT 12PT 20PA 12FW ---18O75H2MD1.5N.SLDPRT
FULL ASSEMBLY 637pm28-03-26/FULL ASSEMBLY/FULL ASSEMBLY V1 -LARA/Buoyancy/Base Plate.SLDPRT
FULL ASSEMBLY 637pm28-03-26/FULL ASSEMBLY/MCG 2101/Toolbox parts/Metric - Straight bevel gear 0.25M 28GT 12PT 20PA 12FW ---28O75H2MD1.5N.SLDPRT
FULL ASSEMBLY 637pm28-03-26/FULL ASSEMBLY/Crab v2/Toolbox parts/Metric - Straight bevel gear 0.25M 20GT 12PT 20PA 12FW ---20O75H2MD1.5N.SLDPRT
FULL ASSEMBLY 637pm28-03-26/FULL ASSEMBLY/MCG 2101/Toolbox parts/Metric - Straight bevel gear 0.25M 16GT 20PT 20PA 12FW ---16O75H2MD1.5N.SLDPRT
FULL ASSEMBLY 637pm28-03-26/FULL ASSEMBLY/Crab v2/Toolbox parts/Metric - Straight bevel gear 0.25M 25GT 12PT 20PA 8FW ---25O75H2MD1.5N.SLDPRT
FULL ASSEMBLY 637pm28-03-26/FULL ASSEMBLY/FULL ASSEMBLY V1 -LARA/Shell+Legs/Belt 4.SLDPRT
FULL ASSEMBLY 637pm28-03-26/FULL ASSEMBLY/MCG 2101/Toolbox parts/Metric - Straight bevel gear 0.25M 20GT 12PT 20PA 12FW ---20O75H2MD4N.SLDPRT
FULL ASSEMBLY 637pm28-03-26/FULL ASSEMBLY/Buoyancy Assembly V5/Buoyancy Assembly V5/Gear Arm 1.SLDPRT
FULL ASSEMBLY 637pm28-03-26/FULL ASSEMBLY/Crab v2/Toolbox parts/Metric - Straight bevel gear 0.25M 20GT 12PT 20PA 12FW ---20O75H3MD4N.SLDPRT
FULL ASSEMBLY 637pm28-03-26/FULL ASSEMBLY/MCG 2101/Toolbox parts/Metric - Straight bevel gear 0.25M 18GT 12PT 20PA 12FW ---18O75H2MD1.5N.SLDPRT
FULL ASSEMBLY 637pm28-03-26/FULL ASSEMBLY/FULL ASSEMBLY V1 -LARA/Buoyancy/Casing.SLDPRT
FULL ASSEMBLY 637pm28-03-26/FULL ASSEMBLY/MCG 2101/Toolbox parts/Metric - Straight bevel gear 0.25M 20GT 12PT 20PA 12FW ---20O75H3MD4N.SLDPRT
FULL ASSEMBLY 637pm28-03-26/FULL ASSEMBLY/Buoyancy Assembly V5/Buoyancy Assembly V5/Pin 3.SLDPRT
FULL ASSEMBLY 637pm28-03-26/FULL ASSEMBLY/Crab v2/MCG2101_P6_Slider.SLDPRT
FULL ASSEMBLY 637pm28-03-26/FULL ASSEMBLY/Crab v2/Toolbox parts/Metric - Straight bevel gear 0.25M 16GT 20PT 20PA 12FW ---16O75H2MD1.5N.SLDPRT
FULL ASSEMBLY 637pm28-03-26/FULL ASSEMBLY/FULL ASSEMBLY V1 -LARA/Shell+Legs/Shaft and Bearing Back Right.SLDPRT
FULL ASSEMBLY 637pm28-03-26/FULL ASSEMBLY/Buoyancy Assembly V5/Buoyancy Assembly V5/Pin.SLDPRT
FULL ASSEMBLY 637pm28-03-26/FULL ASSEMBLY/Crab v2/Toolbox parts/Metric - Straight bevel gear 0.25M 20GT 12PT 20PA 12FW ---20O75H2MD4N.SLDPRT
FULL ASSEMBLY 637pm28-03-26/FULL ASSEMBLY/FULL ASSEMBLY V1 -LARA/Shell+Legs/Shaft and Bearing Back.SLDPRT
FULL ASSEMBLY 637pm28-03-26/FULL ASSEMBLY/MCG 2101/Toolbox parts/Metric - Straight bevel gear 0.25M 25GT 12PT 20PA 8FW ---25O75H2MD1.5N.SLDPRT
FULL ASSEMBLY 637pm28-03-26/FULL ASSEMBLY/Crab v2/Toolbox parts/Metric - Straight bevel gear 0.25M 28GT 12PT 20PA 12FW ---28O75H2MD1.5N.SLDPRT
FULL ASSEMBLY 637pm28-03-26/FULL ASSEMBLY/MCG 2101/MCG2101_P6_2-5_Bearing.SLDPRT
FULL ASSEMBLY 637pm28-03-26/FULL ASSEMBLY/MCG 2101/Toolbox parts/Metric - Straight bevel gear 0.25M 20GT 12PT 20PA 12FW ---20O75H2MD1.5N.SLDPRT
FULL ASSEMBLY 637pm28-03-26/FULL ASSEMBLY/Crab v2/MCG2101_P6_Linkage.SLDPRT
FULL ASSEMBLY 637pm28-03-26/FULL ASSEMBLY/FULL ASSEMBLY V1 -LARA/Buoyancy/Top and Bottom Casing.SLDPRT
FULL ASSEMBLY 637pm28-03-26/FULL ASSEMBLY/Crab v2/MCG2101_P6_ShaftM.SLDPRT
FULL ASSEMBLY 637pm28-03-26/FULL ASSEMBLY/FULL ASSEMBLY V1 -LARA/Buoyancy/Piston.SLDPRT
FULL ASSEMBLY 637pm28-03-26/FULL ASSEMBLY/FULL ASSEMBLY V1 -LARA/Shell+Legs/Trapezoid Belt.SLDPRT
FULL ASSEMBLY 637pm28-03-26/FULL ASSEMBLY/MCG 2101/MCG2101_P6_RightCase.SLDPRT
FULL ASSEMBLY 637pm28-03-26/FULL ASSEMBLY/Crab v2/MCG2101_P6_RightCase.SLDPRT
FULL ASSEMBLY 637pm28-03-26/FULL ASSEMBLY/FULL ASSEMBLY V1 -LARA/Shell+Legs/Leg1_Out.SLDPRT
FULL ASSEMBLY 637pm28-03-26/FULL ASSEMBLY/Crab v2/MCG2101_P6_Slider_V2.SLDPRT
FULL ASSEMBLY 637pm28-03-26/FULL ASSEMBLY/FULL ASSEMBLY V1 -LARA/Buoyancy/Piston Arm 2.SLDPRT
FULL ASSEMBLY 637pm28-03-26/FULL ASSEMBLY/Crab v2/MCG2101_P6_M_Pulley.SLDPRT
FULL ASSEMBLY 637pm28-03-26/FULL ASSEMBLY/FULL ASSEMBLY V1 -LARA/Shell+Legs/Bearing and Shaft Attachment Front.SLDPRT
FULL ASSEMBLY 637pm28-03-26/FULL ASSEMBLY/FULL ASSEMBLY V1 -LARA/Shell+Legs/Leg1_In.SLDPRT
FULL ASSEMBLY 637pm28-03-26/FULL ASSEMBLY/FULL ASSEMBLY V1 -LARA/Shell+Legs/Part2.SLDPRT
FULL ASSEMBLY 637pm28-03-26/FULL ASSEMBLY/FULL ASSEMBLY V1 -LARA/Shell+Legs/Leg4_In.SLDPRT
FULL ASSEMBLY 637pm28-03-26/FULL ASSEMBLY/FULL ASSEMBLY V1 -LARA/Shell+Legs/Bearing and Shaft Attachment Front Right.SLDPRT
FULL ASSEMBLY 637pm28-03-26/FULL ASSEMBLY/FULL ASSEMBLY V1 -LARA/Shell+Legs/Frame_Top.SLDPRT
FULL ASSEMBLY 637pm28-03-26/FULL ASSEMBLY/FULL ASSEMBLY V1 -LARA/Shell+Legs/Belt1.SLDPRT
FULL ASSEMBLY 637pm28-03-26/FULL ASSEMBLY/FULL ASSEMBLY V1 -LARA/Shell+Legs/Part4.SLDPRT
FULL ASSEMBLY 637pm28-03-26/FULL ASSEMBLY/FULL ASSEMBLY V1 -LARA/Shell+Legs/Belt2.SLDPRT
FULL ASSEMBLY 637pm28-03-26/FULL ASSEMBLY/FULL ASSEMBLY V1 -LARA/Shell+Legs/New Claw Design.SLDPRT
FULL ASSEMBLY 637pm28-03-26/FULL ASSEMBLY/FULL ASSEMBLY V1 -LARA/Shell+Legs/In Shaft.SLDPRT
FULL ASSEMBLY 637pm28-03-26/FULL ASSEMBLY/FULL ASSEMBLY V1 -LARA/Shell+Legs/Belt 3.SLDPRT
FULL ASSEMBLY 637pm28-03-26/FULL ASSEMBLY/FULL ASSEMBLY V1 -LARA/Shell+Legs/New Claw Design - Part 1.SLDPRT
FULL ASSEMBLY 637pm28-03-26/FULL ASSEMBLY/FULL ASSEMBLY V1 -LARA/Shell+Legs/Leg6_In.SLDPRT
FULL ASSEMBLY 637pm28-03-26/FULL ASSEMBLY/FULL ASSEMBLY V1 -LARA/Shell+Legs/Leg7_In.SLDPRT
FULL ASSEMBLY 637pm28-03-26/FULL ASSEMBLY/Crab v2/MCG2101_P5_Screw.SLDPRT
FULL ASSEMBLY 637pm28-03-26/FULL ASSEMBLY/FULL ASSEMBLY V1 -LARA/Shell+Legs/Ball (1).SLDPRT
FULL ASSEMBLY 637pm28-03-26/FULL ASSEMBLY/FULL ASSEMBLY V1 -LARA/Shell+Legs/Belt3.SLDPRT
FULL ASSEMBLY 637pm28-03-26/FULL ASSEMBLY/FULL ASSEMBLY V1 -LARA/Shell+Legs/Belt4.SLDPRT
FULL ASSEMBLY 637pm28-03-26/FULL ASSEMBLY/FULL ASSEMBLY V1 -LARA/Shell+Legs/crab leg shell-middle (1).SLDPRT
FULL ASSEMBLY 637pm28-03-26/FULL ASSEMBLY/FULL ASSEMBLY V1 -LARA/Shell+Legs/crab leg shell-top (1).SLDPRT
FULL ASSEMBLY 637pm28-03-26/FULL ASSEMBLY/Full Assembly v1.0.SLDDRW
FULL ASSEMBLY 637pm28-03-26/FULL ASSEMBLY/MCG 2101/MCG2101_P5_Screw.SLDPRT
